bigjosh/BlueLEDBoard/images/daughter.jpeg

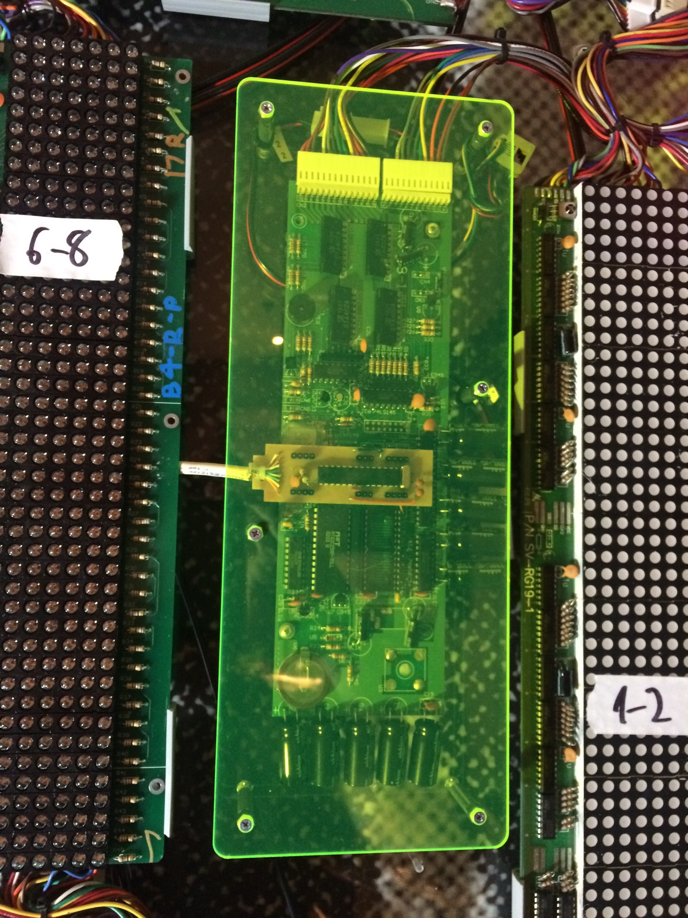
images/daughter.jpeg
