bigjosh/BlueLEDBoard/images/demo.jpg

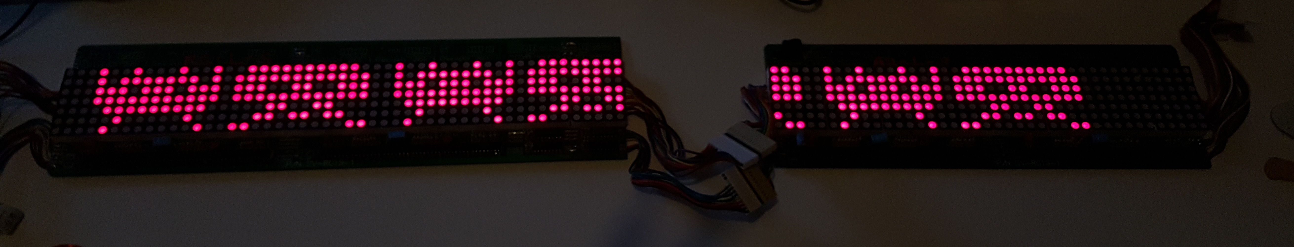
images/demo.jpg
