bigjosh/BlueLEDBoard/tools/IdeaProjects/png2c/Explode.PNG

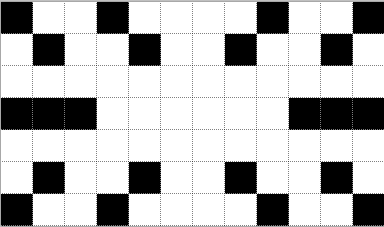
tools/IdeaProjects/png2c/Explode.PNG
