bigjosh/BlueLEDBoard/tools/IdeaProjects/png2c/FTR8PSFHCB8T24U.LARGE.jpg

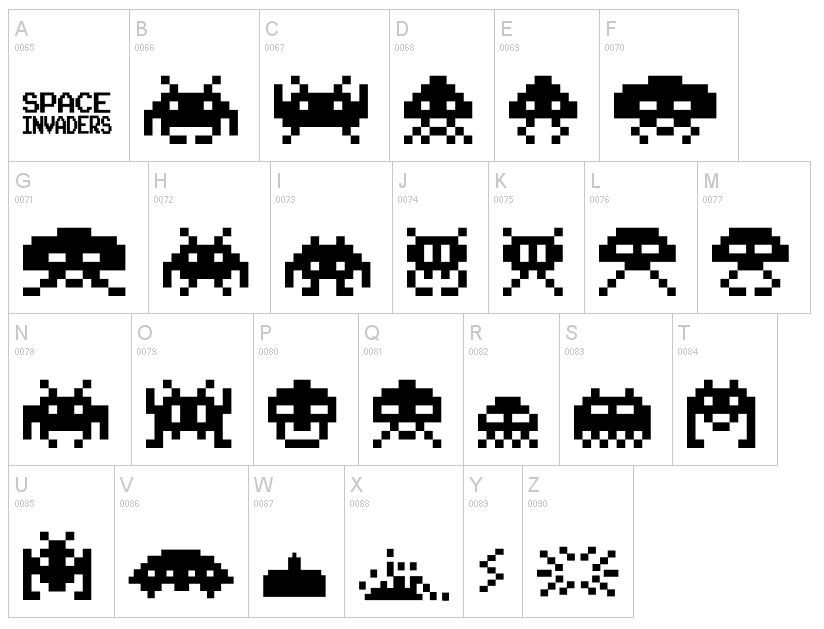
tools/IdeaProjects/png2c/FTR8PSFHCB8T24U.LARGE.jpg
