bigjosh/BlueLEDBoard/tools/IdeaProjects/png2c/grave big.png

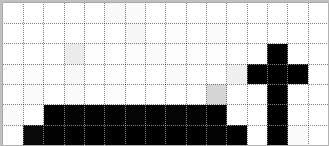
tools/IdeaProjects/png2c/grave big.png
