bigjosh/BlueLEDBoard/tools/IdeaProjects/png2c/output.png

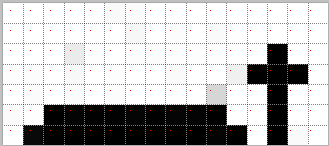
tools/IdeaProjects/png2c/output.png
