bigjosh/BlueLEDBoard/tools/IdeaProjects/png2c/Rubble.PNG

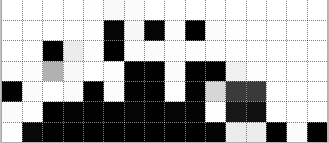
tools/IdeaProjects/png2c/Rubble.PNG
