bigjosh/BlueLEDBoard/master/test.txt

This is a test. I like M*X8E with an hex quoted accented e at the end. Overstrike X*O6-. That should have been an X with a line though it.
