bigjosh/BlueLEDBoard/(commit log)

2015-09-25 Full Working on Arduino Pro Mini
2015-09-30 SPI working, serial commands implimented
2015-10-04 Working with old serial format and 250K baud
    But some missed chars so next step to prepack the SPI bits into the
    serial message
    [BlueLEDBoard.ino]
2015-10-04 Working at 100Kbd with full frame packet
2015-10-04 Windows sample Master driver
2015-10-05 Works generally
    Still too slow and 1st 3 cols are not making onto the display, but works
    good enough for 1st version. Really need to enable ints durring SPI so
    we can speed up serial in and improve frame rate. Need double buffer
    switchover.
    [BlueLEDBoard.ino]
2015-10-05 Baseline working with Windows master prototype- even space invaders works
2015-10-06 Fix packet stuff. Works now at 1mbs!
    [BlueLEDBoard.ino]
2015-10-16 Added PCB
    [d534136d65680292_14448623960000_gerbers.gbl, d534136d65680292_14448623960000_gerbers.gbo, d534136d65680292_14448623960000_gerbers.gbp, d534136d65680292_14448623960000_gerbers.gbs, d534136d65680292_14448623960000_gerbers.gko, d534136d65680292_14448623960000_gerbers.gtl, d534136d65680292_14448623960000_gerbers.gto, d534136d65680292_14448623960000_gerbers.gtp]
2015-10-17 add board images
2015-10-17 Clean up board code
2015-10-17 URLs are case sensitive!
2015-10-21 Countup in demo, and self terminating demo mode
    It now starts a nice digit counter at the end of the demo loop.
    The demo mode also automatically terminates upon reciept of the first
    good frame of data.
2015-10-21 Finally Fixed missing 1st byte bug!
    Stupid typo. Arg.
    [BlueLEDBoard.ino]
2015-10-22 Switched to open() so read(0 can be blocking
2015-10-25 Running well with time in the LED message.
2015-10-28 Ready to install on mounted unit with nice smooth date/port demo scroll
2015-10-29 De-windows-ify the deep directory structure
    [d534136d65680292_14448623960000_gerbers.gbl, d534136d65680292_14448623960000_gerbers.gbo, d534136d65680292_14448623960000_gerbers.gbp, d534136d65680292_14448623960000_gerbers.gbs, d534136d65680292_14448623960000_gerbers.gko, d534136d65680292_14448623960000_gerbers.gtl, d534136d65680292_14448623960000_gerbers.gto, d534136d65680292_14448623960000_gerbers.gtp]
2015-10-29 Fixed padding in firmware
    [BlueLEDBoard.ino]
2015-10-29 Moved location for firmware hex file
    Now you have to export from the arduino IDE manuall
2015-11-04 Reduce frame rate and clock freq to make work with installed panels
2015-11-10 Fixed ping command so it prints fail when the ping doesn't work. Silly linux.
2015-11-12 Fixed a nasty bug where fread(0 doesn't null terminate (switched from gets which did).
2015-11-13 Added external font file. Path currently hard coded.
2015-11-13 Added messages files to turn all LEDs on and off for testing
2015-11-14 Added command to blueled to light a single column and quit. Used by the calibration script to locate LEDs on the visible display area.
2015-11-15 Enable autocalibration using na attached SLD camera pointing at the display surface
    The calibration.sh will light 10 cols at a time and take a photo.
2017-04-04 Added prints to grabdropbox
2017-04-05 Working new config. Updated URLS and added a print after each download to show the Actual message
