bigjosh/BlueLEDBoard/Daughterboard PCB/images/board-bare.jpg

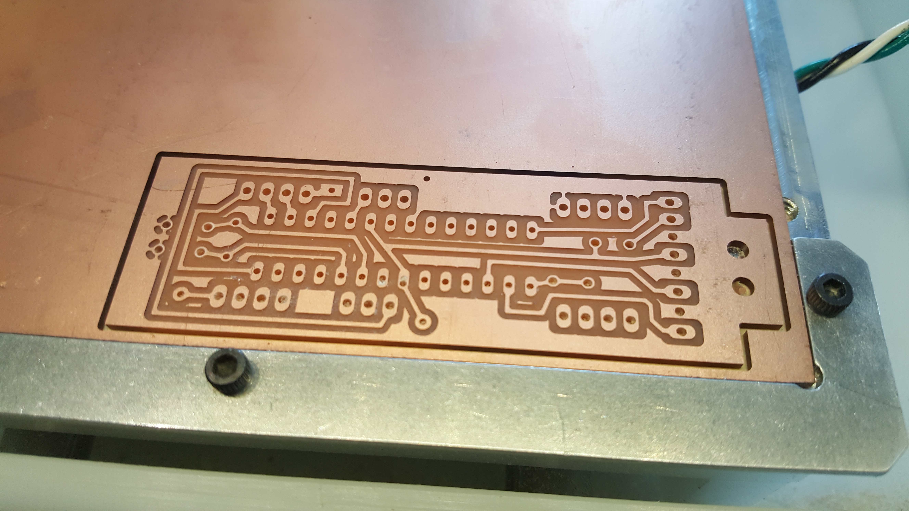
[picture p2: daughterboard/images/board-bare.jpg]
Daughterboard PCB/images/board-bare.jpg
