bigjosh/BlueLEDBoard/Daughterboard PCB/images/board-back.jpg

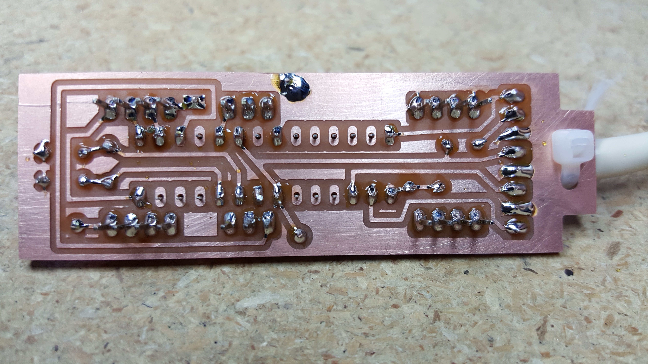
[picture p4: daughterboard/images/board-back.jpg]
Daughterboard PCB/images/board-back.jpg
