bigjosh/BlueLEDBoard/Daughterboard PCB/images/connector-front.jpg

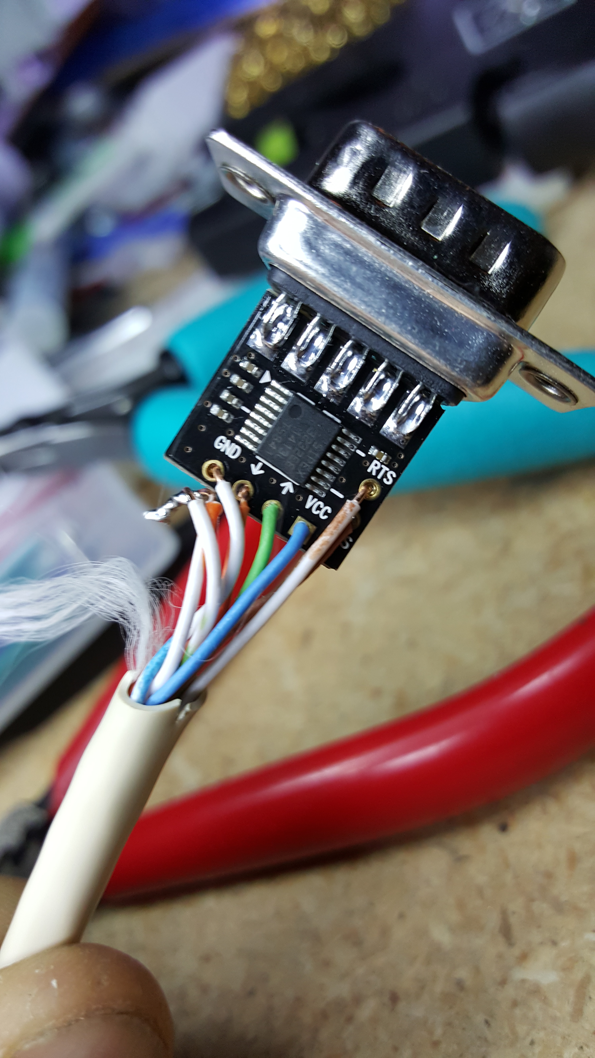
[picture p6: daughterboard/images/connector-front.jpg]
Daughterboard PCB/images/connector-front.jpg
