bigjosh/BlueLEDBoard/Daughterboard PCB/images/connector-back.jpg

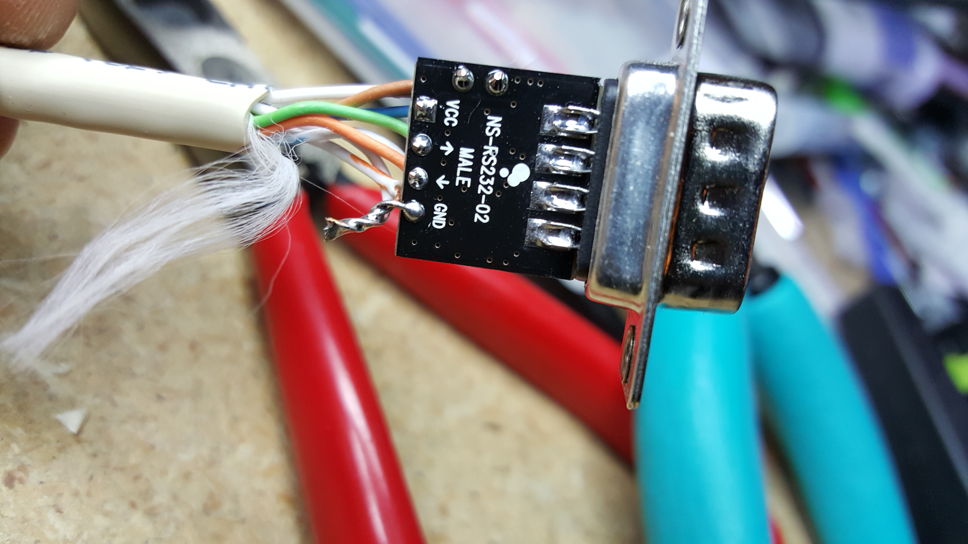
[picture p7: daughterboard/images/connector-back.jpg]
Daughterboard PCB/images/connector-back.jpg
