bigjosh/BlueLEDBoard/daughterboard/images/connector-hood.jpg

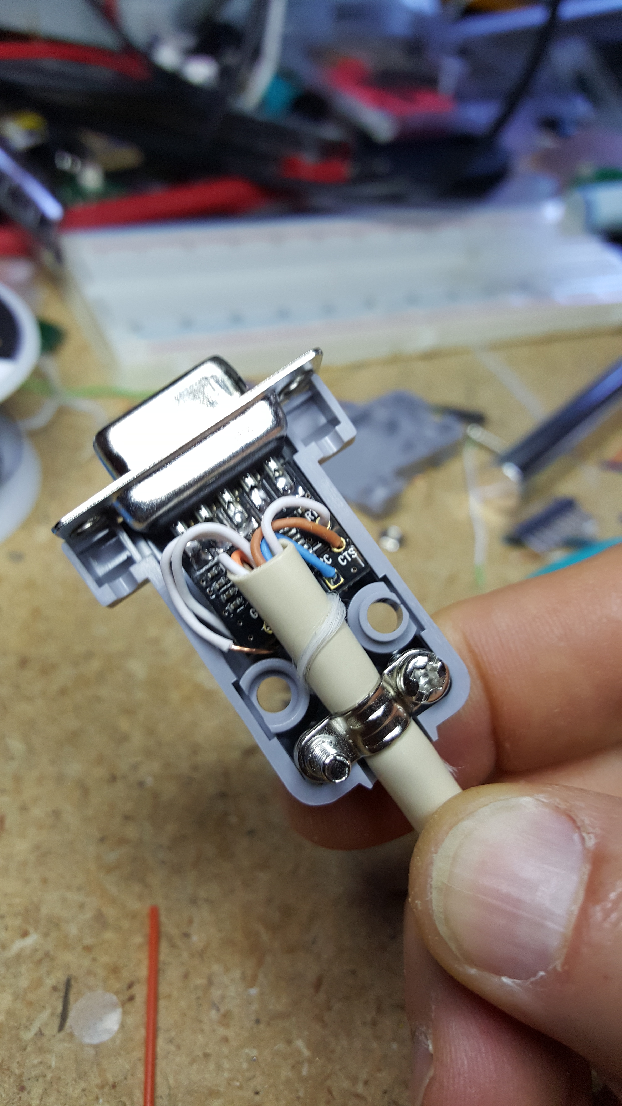
daughterboard/images/connector-hood.jpg
